Chris741233/torque_to_throttle/README.md

# e-bike torque to throttle, test

Discussion en français sur le [forum Cyclurba](https://cyclurba.fr/forum/751958/arduino-l-assistance-d-un-vae.html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)  

### Torque sensor   
marque AXLETORQUEBB68MM (Aliexpress)
5V 50mA MAX, 35mA standard, sortie 0.8-3.7v, 44mV/Nm, 75 Nm max  
<p align="left">
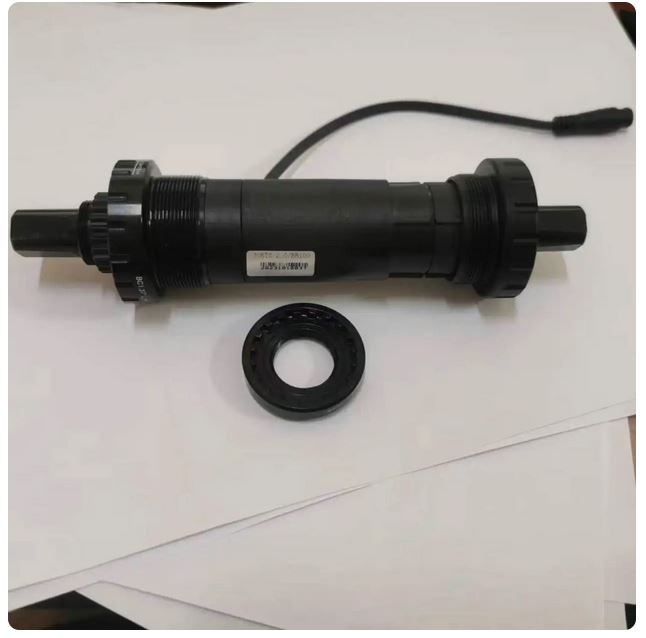
[picture p1: docs/torque_sensor.jpg]
  
</p>

### sensor pin out  
<p align="left">
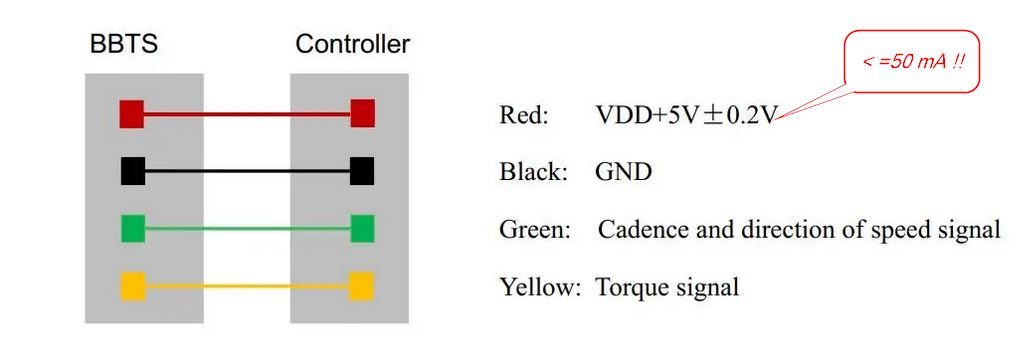
[picture p2: docs/tork_connector.jpg]
  
</p>

### Diagram Arduino Nano
<p align="left">
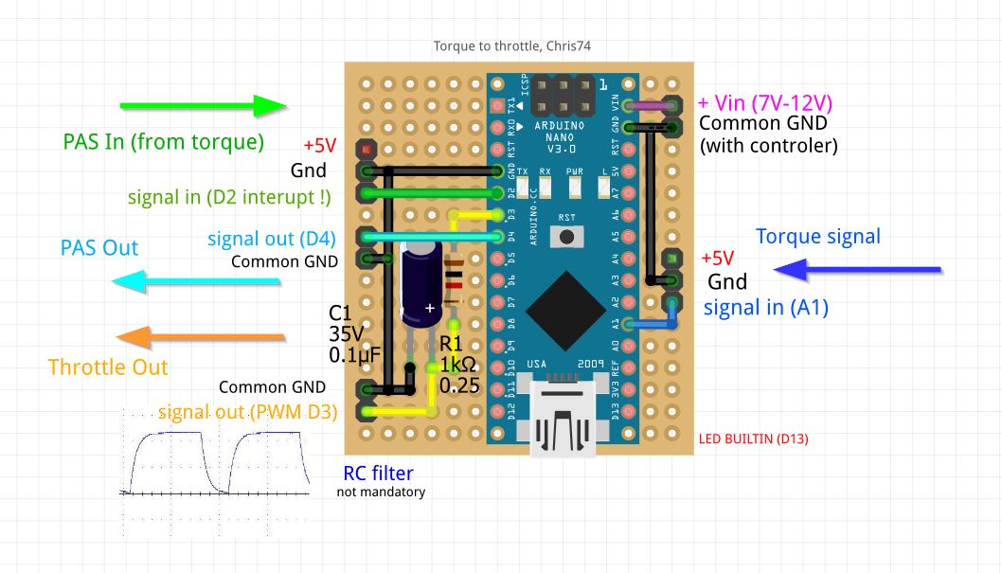
[picture p3: docs/diagram_tork_throttle.jpg]
  
</p>

### Torque diagram
[Source, voir son pdf](https://www.mdpi.com/1424-8220/23/10/4657 " voir son pdf")  
<p align="left">
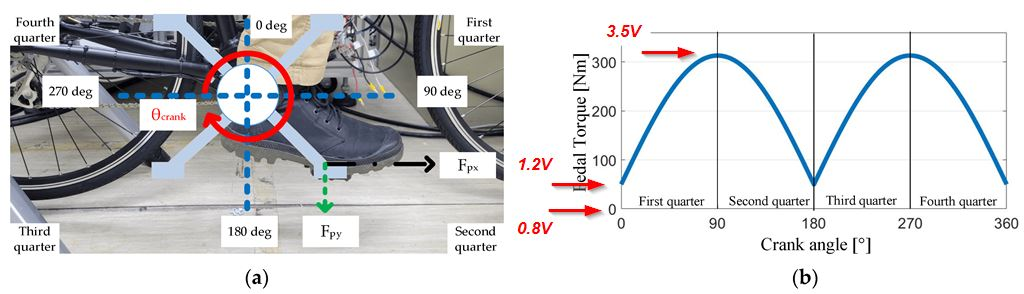
[picture p4: docs/tork_diagram.jpg]
    
</p>

### Banc de simulation  (M5Stack + Arduino Nano)  
<p align="left">
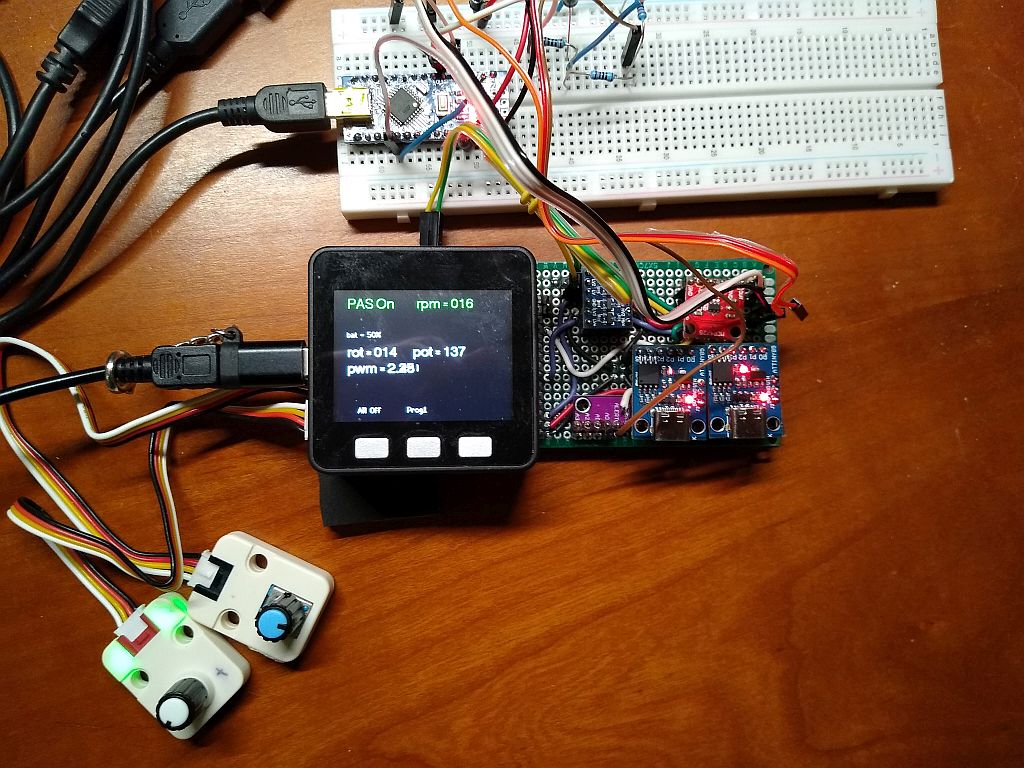
[picture p5: docs/simulator1.jpg]
  
</p>

### Génération des signaux PAS et Torque
<p align="left">
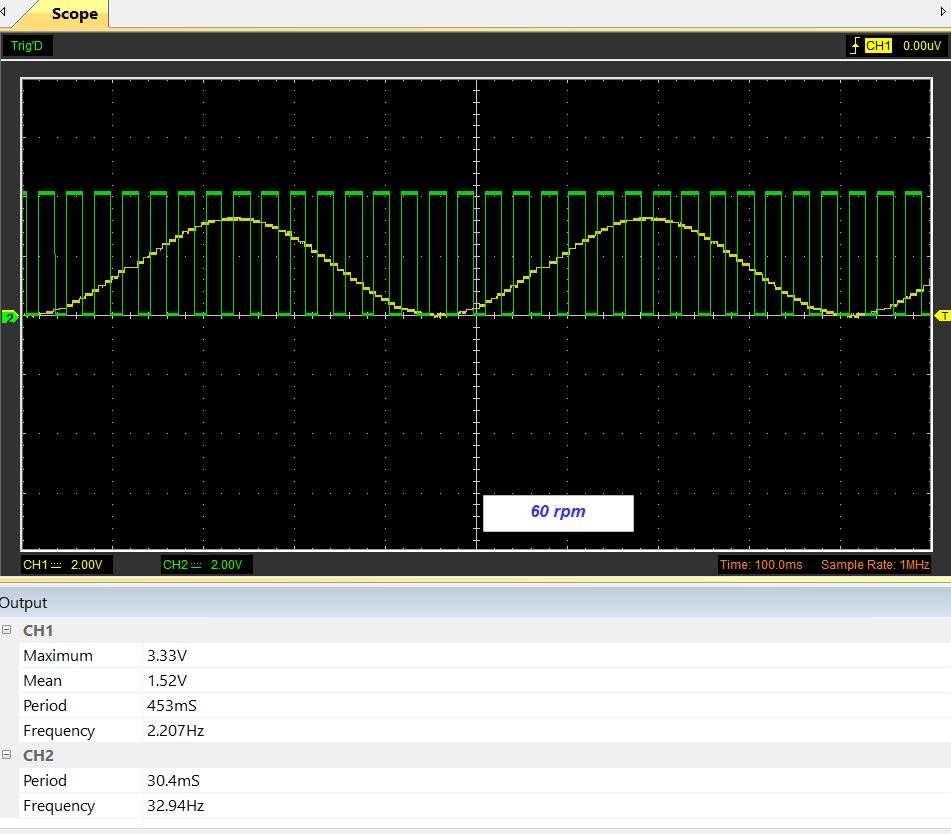
[picture p6: docs/banc_test1.jpg]
  
</p>

### signal PWM OUT (vers throttle controleur)  
filtre RC comme sur schéma, vérification sur oscillo + voltmètre de labo.
La tension DC est stable et cohérente selon réglage Vref.  
<p align="left">
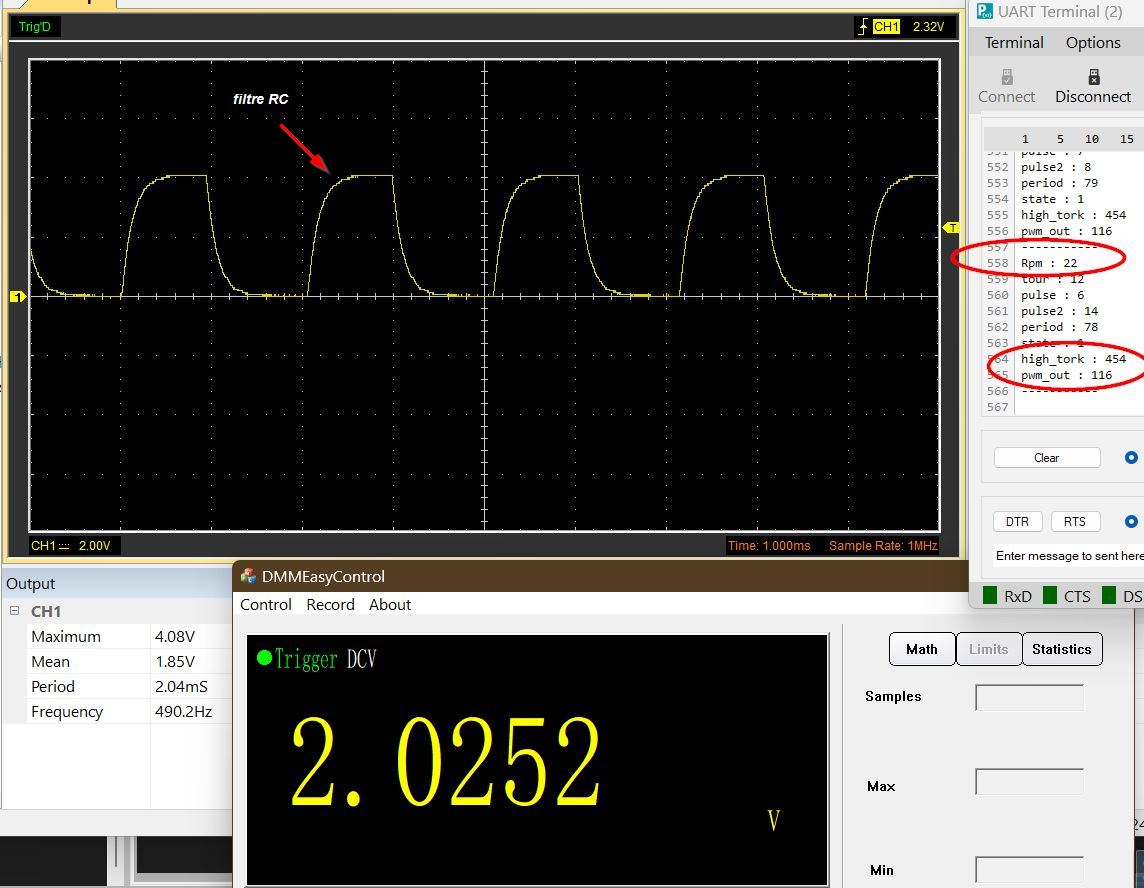
[picture p7: docs/banc_test2.jpg]
  
</p>
