Chris741233/torque_to_throttle/(list of files, drawings)

Other design files:
docs/diagram_tork_throttle.fzz
